spacemonger/flux-capacitor/Flux Capacitor Presentation.pdf

# - Flux Capacitor -

# A State of Charge (SOC) and State of Health (SOH) estimator for Batteries with Improved Coulomb Counting Technique

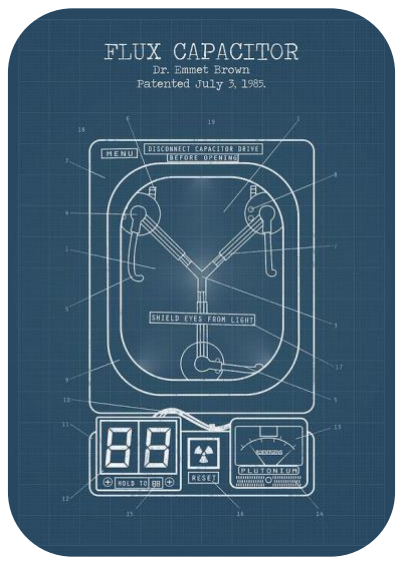
[picture p20: figure]

A thesis by Frank Li
Flux
2020-06-12

# Abstract

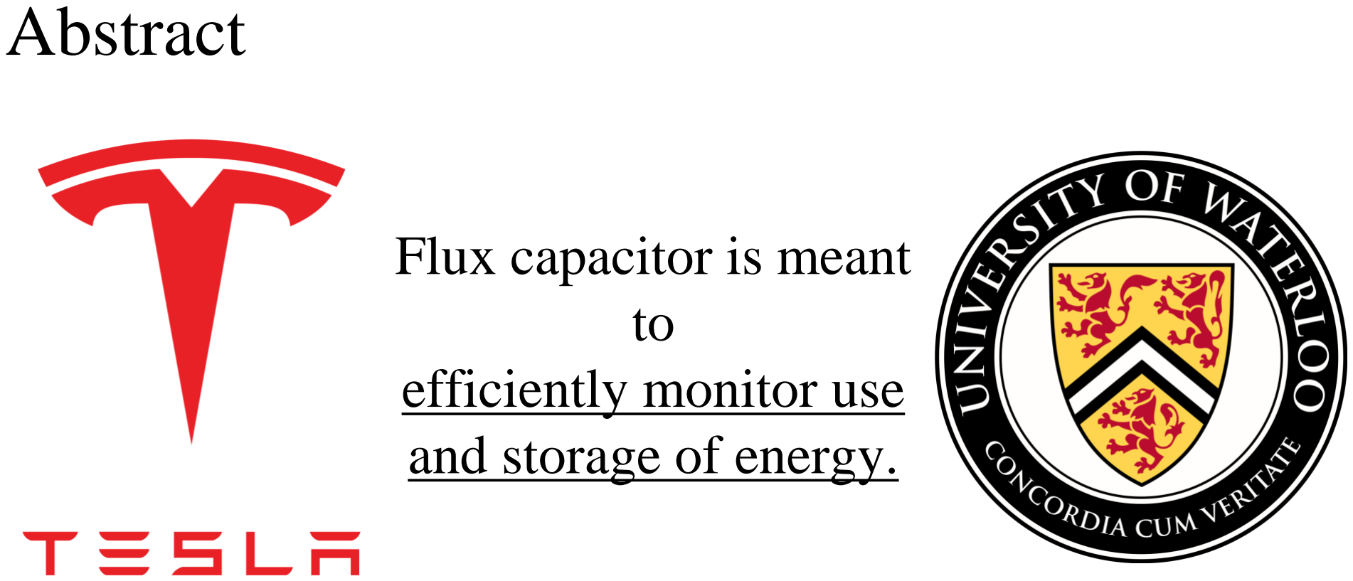
[picture p21: page 2]

# Flux capacitor is meant

to

# efficiently monitor use

and storage of energy.

# Design of System

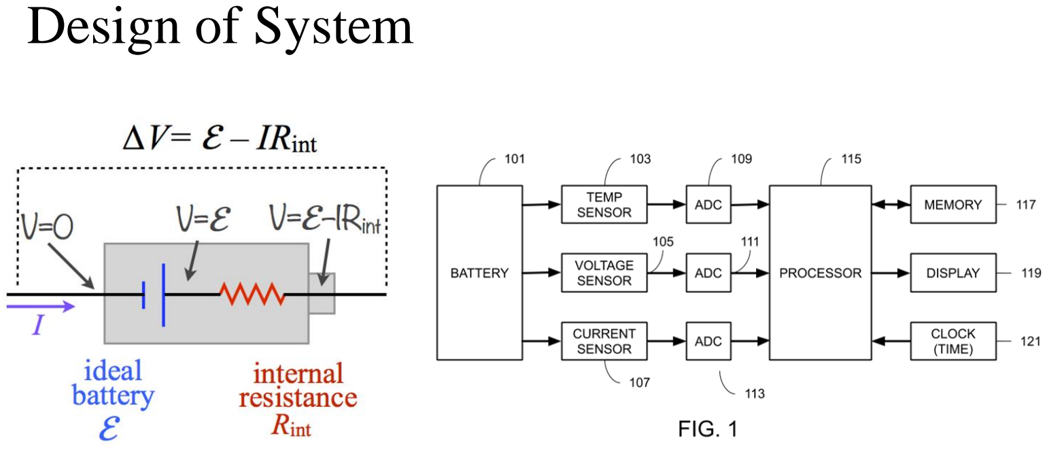
[picture p22: page 3]

# Hardware

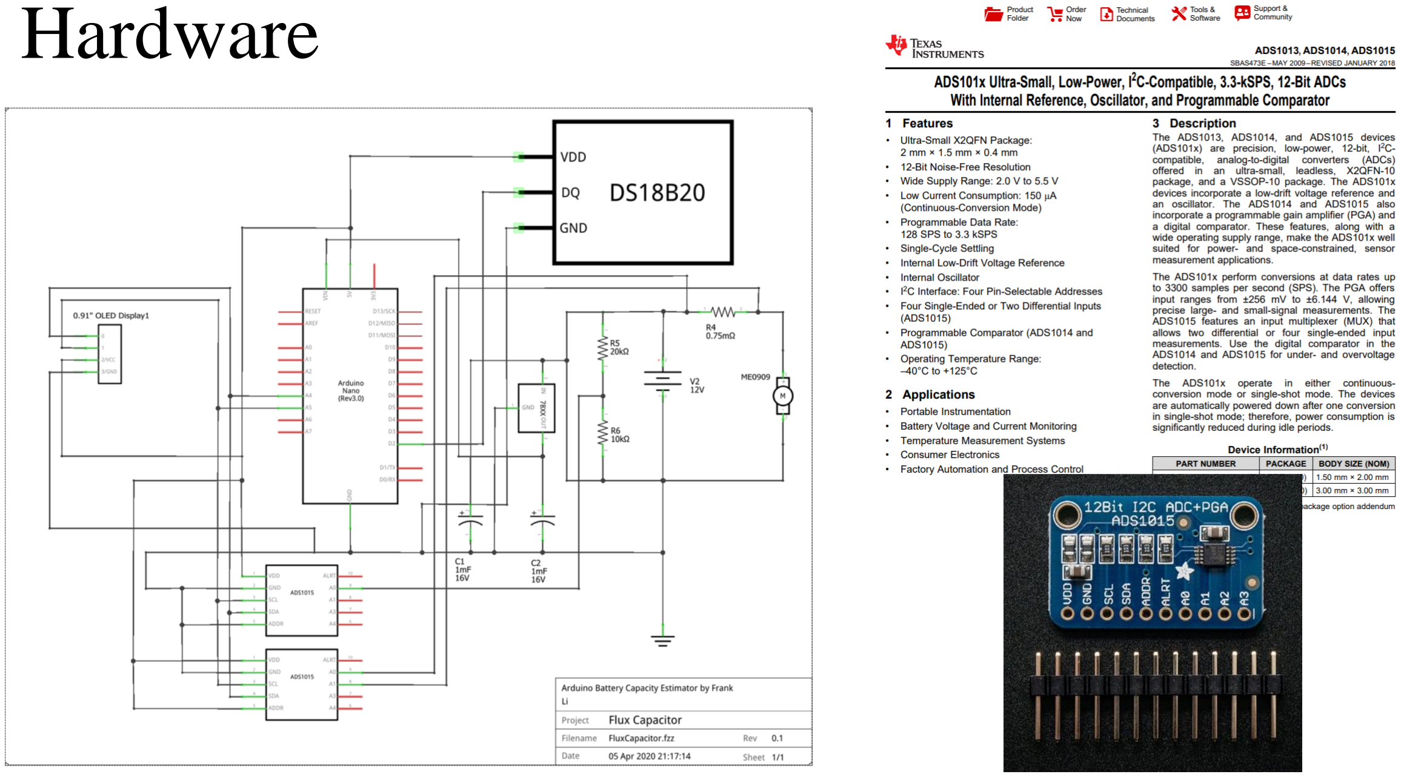
[picture p23: page 4]
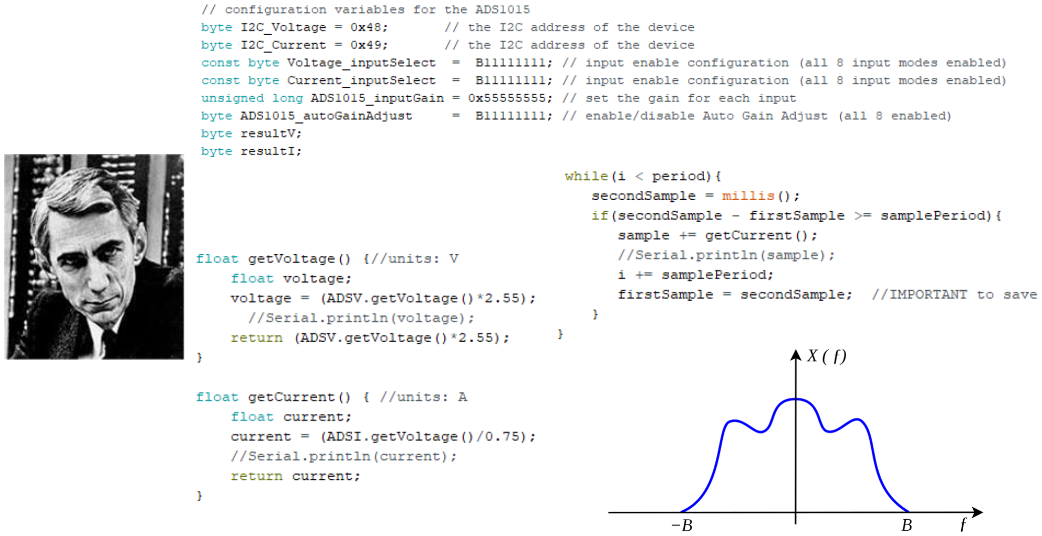
[picture p24: page 5]
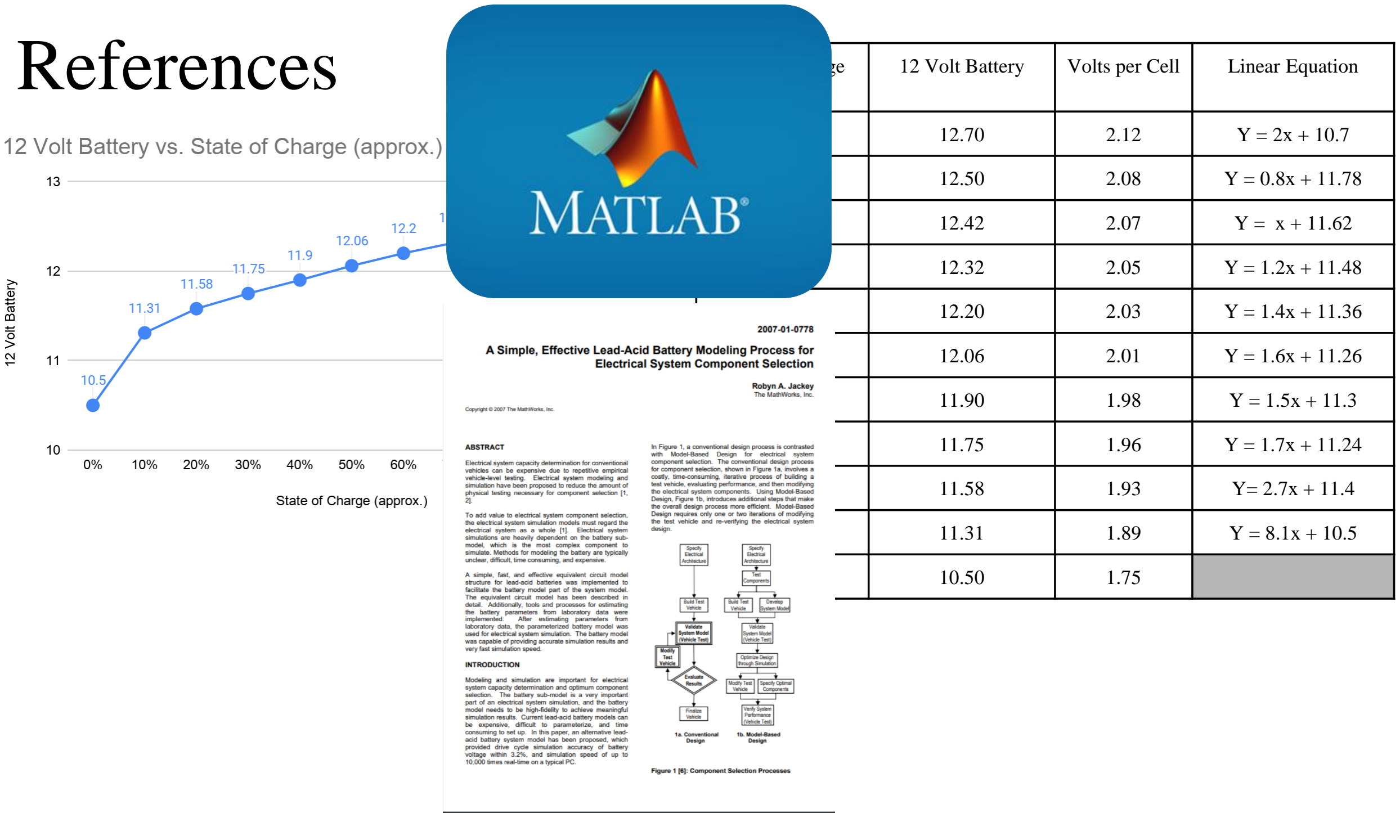
[picture p25: page 6]

References | State of Charge
(approx.) | 12 Volt Battery | Volts per Cell | Linear Equation
100% | 12.70 | 2.12 | Y = 2x + 10.7
90% | 12.50 | 2.08 | Y = 0.8x + 11.78
80% | 12.42 | 2.07 | Y = x + 11.62
70% | 12.32 | 2.05 | Y = 1.2x + 11.48
60% | 12.20 | 2.03 | Y = 1.4x + 11.36
50% | 12.06 | 2.01 | Y = 1.6x + 11.26
40% | 11.90 | 1.98 | Y = 1.5x + 11.3
30% | 11.75 | 1.96 | Y = 1.7x + 11.24
20% | 11.58 | 1.93 | Y= 2.7x + 11.4
10% | 11.31 | 1.89 | Y = 8.1x + 10.5
0% | 10.50 | 1.75

# Firmware

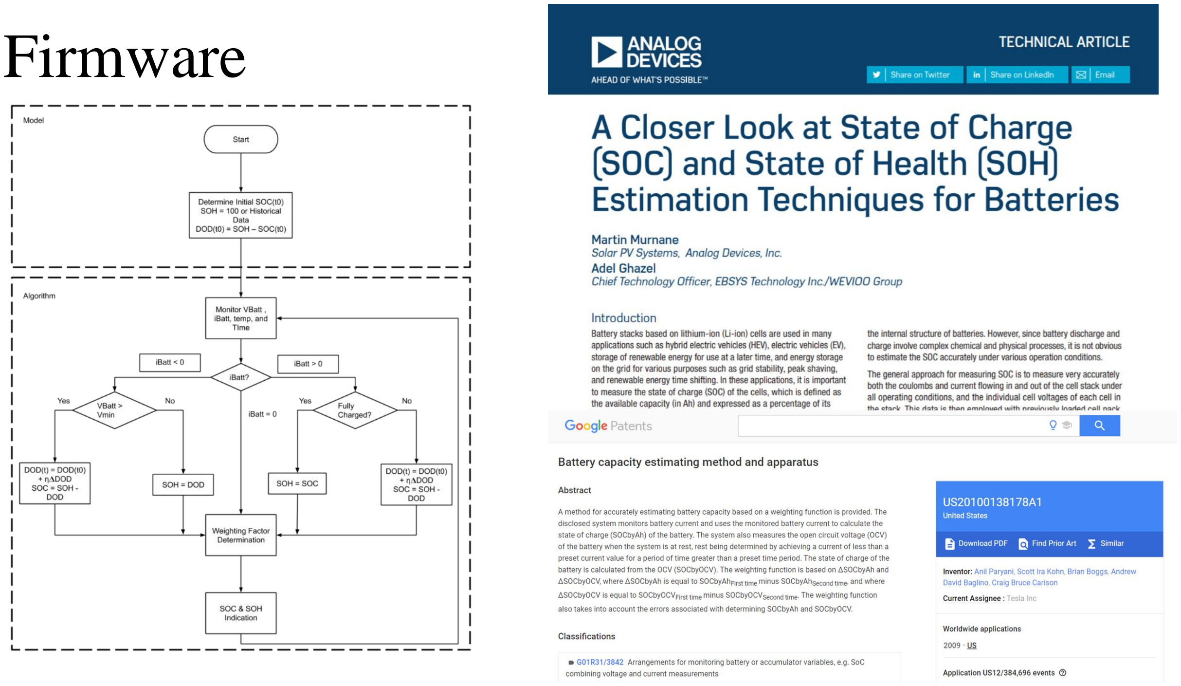
[picture p26: page 7]
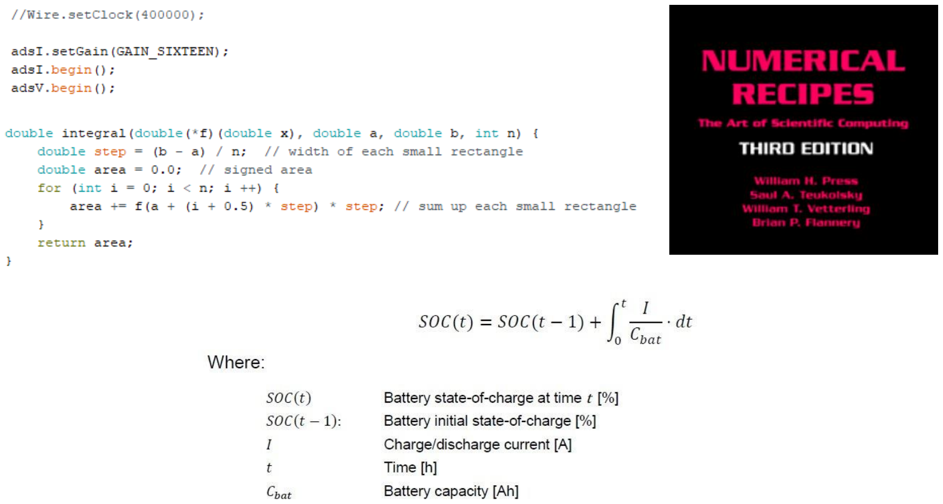
[picture p27: page 8]

# Lessons learnt

# - Make sure to purchase hardware that fit the requirements, try to follow them as

# closely as possible

# - Double check circuits and collaborate

# - Firmware quality is heavily dependant on understanding of the scientific background

# Demo Time
