spacemonger/flux-capacitor/FluxCapacitor_schem.png

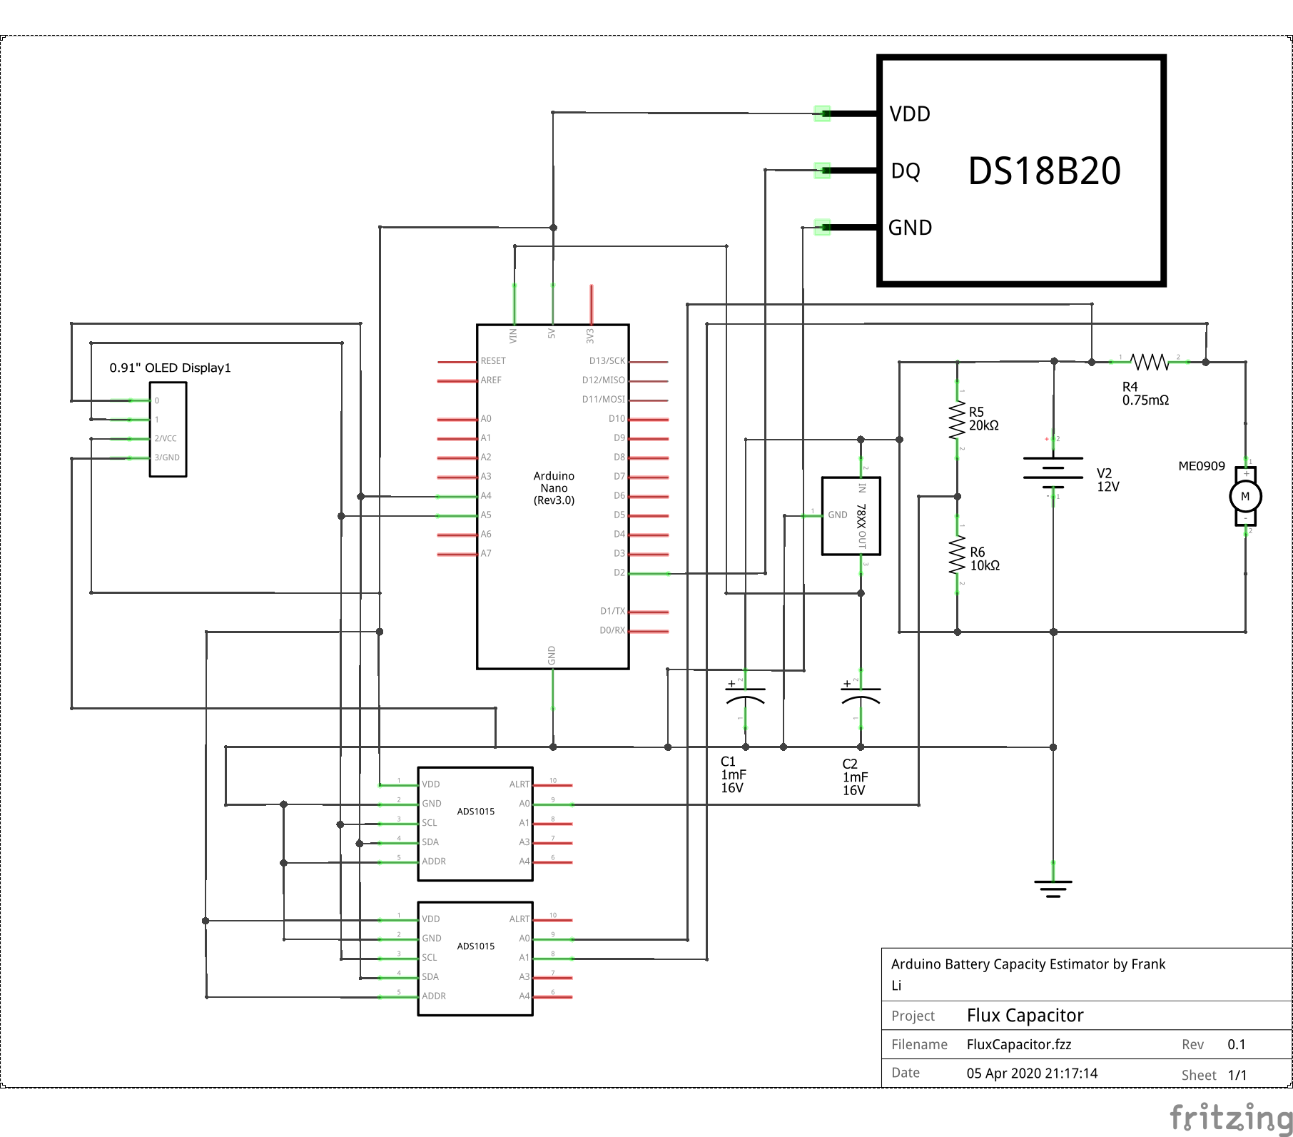
FluxCapacitor_schem.png
